GadgetReboot/8ChLED/README.md

# 8ChLED
8 Addressable LEDs show logic input high/low states for easy probing
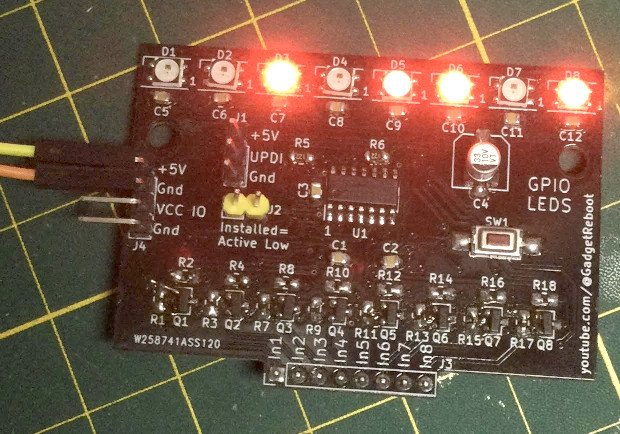
[picture p1: Assembled_PCB.jpg]
PCB
<br><br><BR><BR>
