GadgetReboot/8ChLED/Sch_GR_ATTiny_LED.pdf

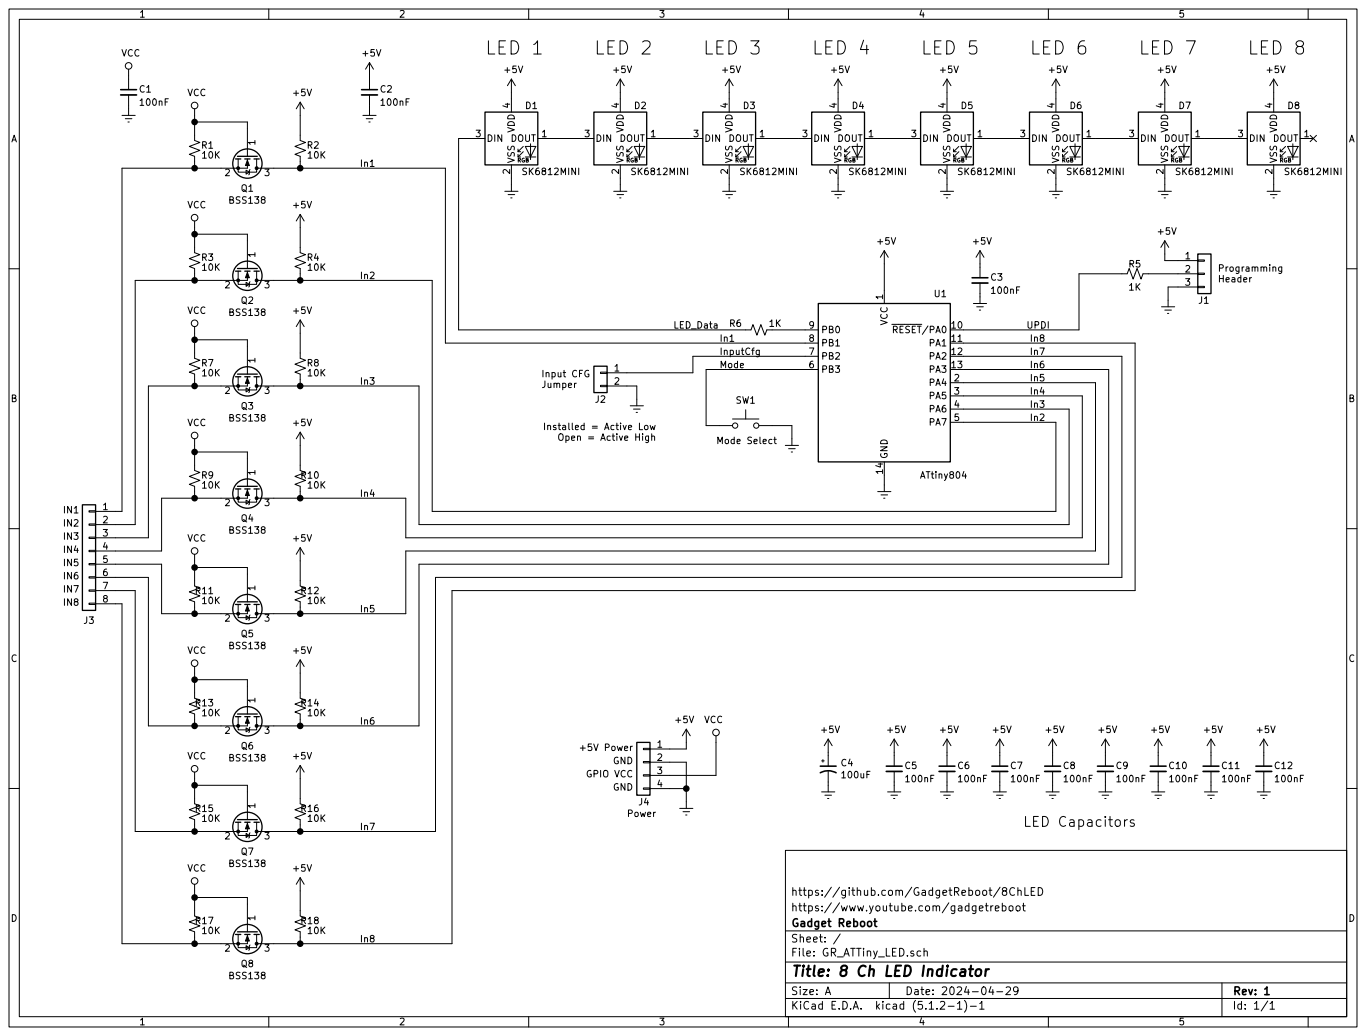
[picture p2: page 1]

4D8 SK6812MINI +5V LED 1 LED 2 LED 3 LED 4 LED 5 LED 6 LED 7 LED 8

2 DIN 3 VDD
https://github.com/GadgetReboot/8ChLED VCC

+5V Power
J4 GND GND GPIO VCC

https://www.youtube.com/gadgetreboot
File: GR_ATTiny_LED.sch Sheet: / Gadget Reboot

Id: 1/1 Title: 8 Ch LED Indicator
