GadgetReboot/8ChLED/KiCad/GR_ATTiny_LED.kicad_pcb

## KiCad design KiCad/GR_ATTiny_LED.kicad_pcb (2024-05-27)

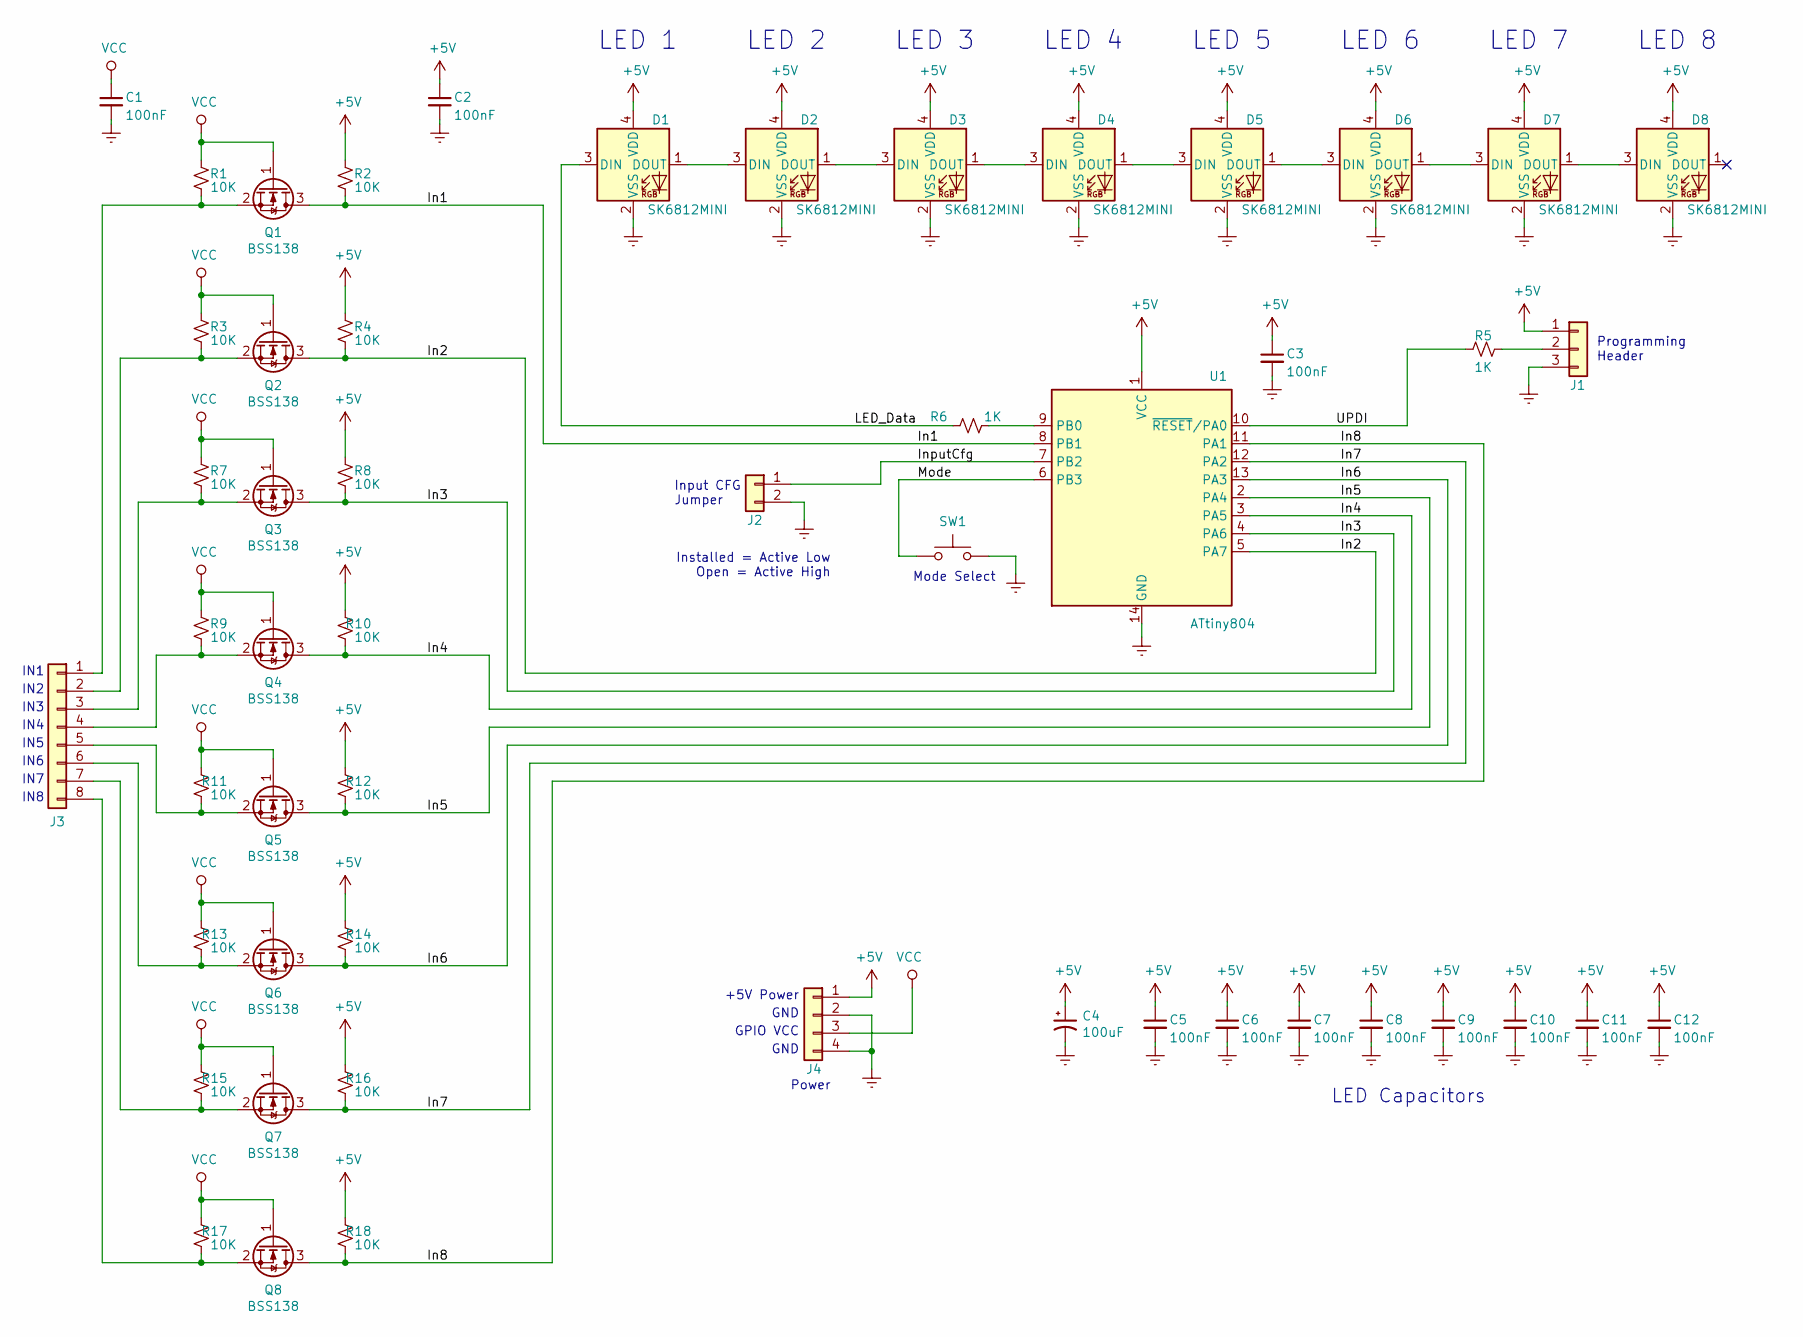
[picture p3: schematic GR_ATTiny_LED.sch, 8 Ch LED Indicator]

Parts:
C1, C2, C3, C5, C6, C7, C8, C9, C10, C11, C12: 100nF; C_0805_2012Metric_Pad1.15x1.40mm_HandSolder
C4: 100uF; C_Elec_6.3x5.8
D1, D2, D3, D4, D5, D6, D7, D8: SK6812MINI; LED_SK6812MINI_4_3.5x3.5mm_P1.75mm
J1: Conn_01x03; PinHeader_1x03_P2.54mm_Vertical
J2: Conn_01x02; PinHeader_1x02_P2.54mm_Vertical
J3: Conn_01x08; PinHeader_1x08_P2.54mm_Vertical
J4: Conn_01x04; PinHeader_1x04_P2.54mm_Vertical
Q1, Q2, Q3, Q4, Q5, Q6, Q7, Q8: BSS138; SOT-23
R1, R2, R3, R4, R7, R8, R9, R10, R11, R12, R13, R14, R15, R16, R17, R18: 10K; R_0805_2012Metric_Pad1.15x1.40mm_HandSolder
R5, R6: 1K; R_0805_2012Metric_Pad1.15x1.40mm_HandSolder
SW1: SW_Push; SW_SPST_60x35
U1: ATtiny804; SOIC-14_3.9x8.7mm_P1.27mm

Connections:
+5V: C2.1, C3.1, C4.1, C5.1, C6.1, C7.1, C8.1, C9.1, C10.1, C11.1, C12.1, D1.4 (VDD), D2.4 (VDD), D3.4 (VDD), D4.4 (VDD), D5.4 (VDD), D6.4 (VDD), D7.4 (VDD), D8.4 (VDD), J1.1, J4.1, R2.1, R4.1, R8.1, R10.1, R12.1, R14.1, R16.1, R18.1, U1.1 (VCC)
/In1: Q1.3 (D), R2.2, U1.8 (PB1)
/In2: Q2.3 (D), R4.2, U1.5 (PA7)
/In3: Q3.3 (D), R8.2, U1.4 (PA6)
/In4: Q4.3 (D), R10.2, U1.3 (PA5)
/In5: Q5.3 (D), R12.2, U1.2 (PA4)
/In6: Q6.3 (D), R14.2, U1.13 (PA3)
/In7: Q7.3 (D), R16.2, U1.12 (PA2)
/In8: Q8.3 (D), R18.2, U1.11 (PA1)
/InputCfg: J2.1, U1.7 (PB2)
/LED_Data: D1.3 (DIN), R6.2
/Mode: SW1.1, U1.6 (PB3)
/UPDI: R5.2, U1.10 (~RESET~/PA0)
GNDREF: C1.2, C2.2, C3.2, C4.2, C5.2, C6.2, C7.2, C8.2, C9.2, C10.2, C11.2, C12.2, D1.2 (VSS), D2.2 (VSS), D3.2 (VSS), D4.2 (VSS), D5.2 (VSS), D6.2 (VSS), D7.2 (VSS), D8.2 (VSS), J1.3, J2.2, J4.2, J4.4, SW1.2, U1.14 (GND)
unnamed: D1.1 (DOUT), D2.3 (DIN)
unnamed: D2.1 (DOUT), D3.3 (DIN)
unnamed: D3.1 (DOUT), D4.3 (DIN)
unnamed: D4.1 (DOUT), D5.3 (DIN)
unnamed: D5.1 (DOUT), D6.3 (DIN)
unnamed: D6.1 (DOUT), D7.3 (DIN)
unnamed: D7.1 (DOUT), D8.3 (DIN)
unnamed: J1.2, R5.1
unnamed: J3.1, Q1.2 (S), R1.2
unnamed: J3.2, Q2.2 (S), R3.2
unnamed: J3.3, Q3.2 (S), R7.2
unnamed: J3.4, Q4.2 (S), R9.2
unnamed: J3.5, Q5.2 (S), R11.2
unnamed: J3.6, Q6.2 (S), R13.2
unnamed: J3.7, Q7.2 (S), R15.2
unnamed: J3.8, Q8.2 (S), R17.2
unnamed: R6.1, U1.9 (PB0)
VCC: C1.1, J4.3, Q1.1 (G), Q2.1 (G), Q3.1 (G), Q4.1 (G), Q5.1 (G), Q6.1 (G), Q7.1 (G), Q8.1 (G), R1.1, R3.1, R7.1, R9.1, R11.1, R13.1, R15.1, R17.1

Notes on the sheet:
Programming Header
LED Capacitors
LED 1
LED 2
LED 3
LED 4
LED 5
LED 6
LED 7
LED 8
IN1
IN2
IN3
IN4
IN5
IN6
IN7
IN8
Input CFG Jumper
Installed = Active Low Open = Active High
Mode Select
Power
GND
GPIO VCC
+5V Power

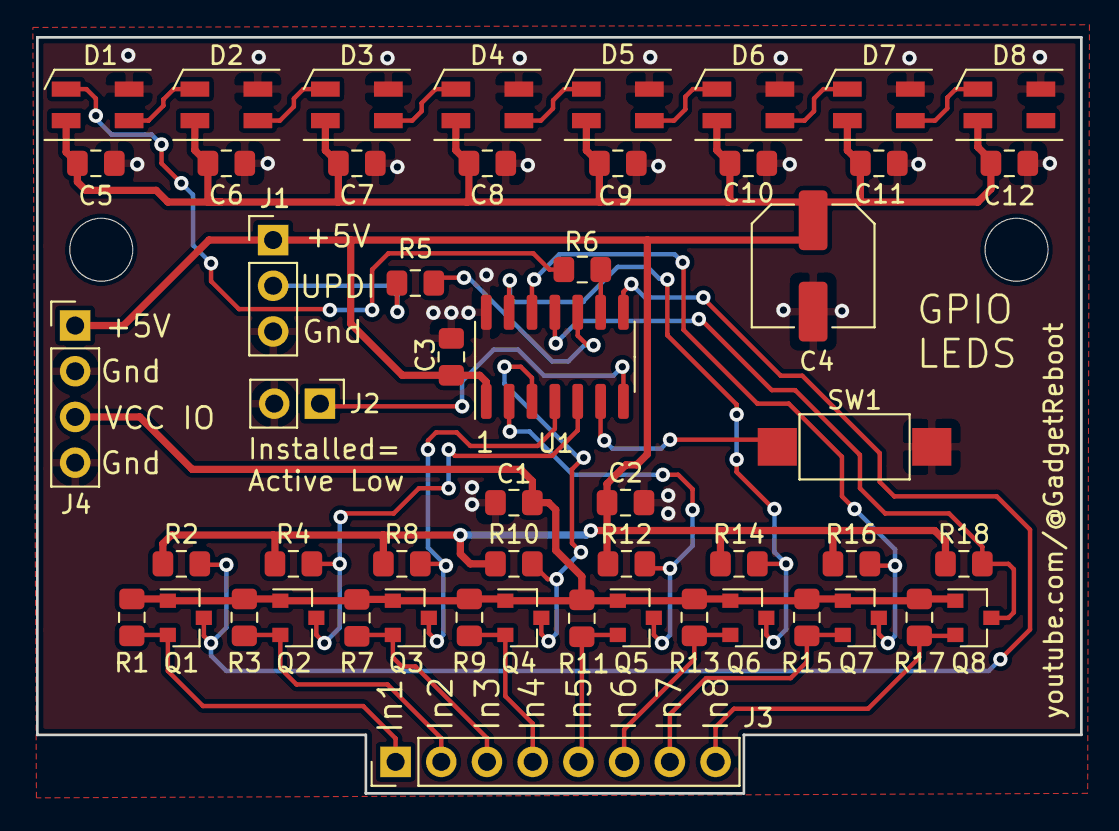
[picture p4: board GR_ATTiny_LED.kicad_pcb from above]

Board: 2 copper layers, 58.0 x 42.0 mm, 52 parts (0 on the bottom side), 32 nets.
